xzhang03/DumberboxPCB/v1.3/PCB Dumberbox BOM.xlsx

Country of Origin may be different at time of shipment.
The HTSUS and ECCN information shown is for informational purposes only and is not a representation or warranty as to the accuracy or reliability of these classifications. All information is provided "as is" and is subject to change without notice. Any use made of the information provided is without recourse to Digi-Key and at the user's risk.
Index | Manufacturer Part Number | Manufacturer Name | Description | Availability | Stock Status | Attrition % | Requested Quantity 1 | Pack Quantity 1 | Pack Type 1 | Digi-Key Part Number 1 | Unit Price 1 | Extended Price 1 | Minimum Order Quantity 1 | Customer Reference | Requested Part Number | Lead Weeks | Datasheet | Reference Designator | US Import Tariff | Note | Part Status | RoHS Status | ECCN | HTSUS | Country of Origin | Environmental Information | Original Part numbers | Image
1 | 74HC14D-Q100,118 | Nexperia USA Inc. | IC INVERT SCHMITT 6CH 1-INP 14SO | 0 | Normally Stocking |  | 1 | 1 | Cut Tape (CT) | 1727-1029-1-ND | 0.53000 | $0.53 | 1 |  | 74HC14D-Q100,118 | 27 | https://assets.nexperia.com/documents/data-sheet/74HC_HCT14_Q100.pdf |  | May apply on shipments to the U.S. |  | Active | ROHS3 Compliant | EAR99 | 8542.39.0001 | China |  | 74HC14D-Q100,118 | //media.digikey.com/Renders/NXP%20Semi%20Renders/14-SOIC-SOT108-1.jpg
2 | 3677 | Adafruit Industries LLC | ITSY BITSY 32U4 5V 16MHZ EVAL BD | 154 | In Stock |  | 1 | 1 | Bulk | 1528-2501-ND | 9.95000 | $9.95 | 1 |  | 1528-2501-ND | 2 | https://cdn-learn.adafruit.com/downloads/pdf/introducting-itsy-bitsy-32u4.pdf |  | N/A |  | Active | ROHS3 Compliant | EAR99 | 8471.50.0150 | United States |  | 1528-2501-ND | //media.digikey.com/Photos/Adafruit%20Industries%20LLC/MFG_3677.jpg
3 | NCP1117ST50T3G | onsemi | IC REG LINEAR 5V 1A SOT223 | 242 | In Stock |  | 1 | 1 | Cut Tape (CT) | NCP1117ST50T3GOSCT-ND | 0.72000 | $0.72 | 1 |  | NCP1117ST50T3G | 58 | https://www.onsemi.com/pdf/datasheet/ncp1117-d.pdf |  | N/A |  | Active | ROHS3 Compliant | EAR99 | 8542.39.0001 | Malaysia | https://www.onsemi.com/PowerSolutions/MaterialComposition.do?export=pdf&opnId=NCP1117ST50T3G|https://www.onsemi.com/site/pdf/RoHS-statement.pdf|https://www.onsemi.com/site/pdf/REACH-compliance-statement.pdf | NCP1117ST50T3G | //media.digikey.com/Renders/Diodes%20Renders/SOT223-3L.jpg
4 | SJ-435107RS | CUI Devices | CONN JACK 4COND 3.5MM R/A | 15,403 | In Stock |  | 2 | 2 | Tray | CP-435107RS-ND | 1.78000 | $3.56 | 1 |  | CP-435107RS-ND | 24 | https://www.cuidevices.com/product/resource/sj-435107.pdf |  | N/A |  | Active | ROHS3 Compliant | EAR99 | 8536.69.4040 | China | https://www.cuidevices.com/product/resource/material-compliance/sj-435107-series | CP-435107RS-ND | //media.digikey.com/Photos/CUI%20Photos/MFG_SJ-435107.jpg
5 | 1-2834015-6 | TE Connectivity AMP Connectors | TERM BLK 6POS TOP ENT 2.54MM PCB | 1,683 | In Stock |  | 1 | 1 | Bulk | A123828-ND | 2.41000 | $2.41 | 1 |  | 1-2834015-6 | 39 | https://www.te.com/commerce/DocumentDelivery/DDEController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 |  | May apply on shipments to the U.S. |  | Active | RoHS Compliant | EAR99 | 8536.69.4040 | China |  | 1-2834015-6 | //media.digikey.com/photos/TE%20Connectivity/1-2834015-6.JPG
6 | PJ-102A | CUI Devices | CONN PWR JACK 2X5.5MM SOLDER | 92,528 | In Stock |  | 1 | 1 | Tray | CP-102A-ND | 0.77000 | $0.77 | 1 |  | PJ-102A | 24 | https://www.cuidevices.com/product/resource/pj-102a.pdf |  | N/A |  | Active | ROHS3 Compliant | EAR99 | 8536.69.4040 | China | https://www.cuidevices.com/product/resource/material-compliance/pj-102a | PJ-102A | //media.digikey.com/Photos/CUI%20Photos/PJ-102A.jpg
7 | XCMDK12D | SunLED | 5MM LC RED LED | 14,206 | In Stock |  | 1 | 1 | Bulk | 1497-XCMDK12D-ND | 0.35000 | $0.35 | 1 |  | 1497-XCMDK12D-ND | 8 | https://www.sunledusa.com/products/spec/XCMDK12D.pdf |  | May apply on shipments to the U.S. |  | Active | ROHS3 Compliant | EAR99 | 8541.41.0000 | China |  | 1497-XCMDK12D-ND | //media.digikey.com/Photos/SunLED/MFG_XCMDK12D.jpg
8 | AB11AH-HC | NKK Switches | SWITCH PUSH SPST-NO 0.4VA 28V | 2,152 | In Stock |  | 3 | 3 | Tray | 360-2604-ND | 6.46000 | $19.38 | 1 |  | AB11AH-HC | 22 | https://www.nkkswitches.com/pdf/Apushbuttons.pdf |  | N/A |  | Active | ROHS3 Compliant | EAR99 | 8536.50.9031 | Japan | https://www.nkkswitches.com/pdf/Switches-and-Pushbuttons-RoHS-Certificate-of-Compliance.pdf|https://www.nkkswitches.com/pdf/PFOS-and-PFOA-Free-Certificate.pdf|https://www.nkkswitches.com/pdf/Ozone-Depleting-Chemical-Free-Manufacturing-Certificate-.pdf | AB11AH-HC | //media.digikey.com/Photos/NKK%20Switches%20Photos/MFG_AB11AH-HC-RO.jpg
9 | 0731375003 | Molex | CONN BNC RCPT R/A 50 OHM PCB | 29,362 | In Stock |  | 4 | 4 | Tray | WM5514-ND | 2.65000 | $10.60 | 1 |  | 0731375003 | 12 | https://www.molex.com/pdm_docs/sd/731375003_sd.pdf |  | N/A |  | Active | ROHS3 Compliant | EAR99 | 8536.69.4010 | Taiwan |  | 0731375003 | //media.digikey.com/Photos/Molex/0731375003.jpg
10 | CR0805-FX-1000ELF | Bourns Inc. | RES SMD 100 OHM 1% 1/8W 0805 | 400,931 | In Stock |  | 4 | 4 | Cut Tape (CT) | CR0805-FX-1000ELFCT-ND | 0.10000 | $0.40 | 1 |  | CR0805-FX-1000ELFCT-ND | 15 | https://www.bourns.com/docs/product-datasheets/cr.pdf?sfvrsn=574d41f6_14 |  | N/A |  | Active | ROHS3 Compliant | EAR99 | 8533.21.0030 | Taiwan | https://www.bourns.com/docs/Product-MDS/cr0805_mds.pdf|https://www.bourns.com/docs/rohs-cofc/crx_coc.pdf?sfvrsn=db3a74f6_10|https://www.bourns.com/docs/rohs-content/bourns-reach-letter.pdf | CR0805-FX-1000ELFCT-ND | //media.digikey.com/Renders/Bourns%20Renders/CR0805-(2012-Metric).jpg
11 | CR0805-FX-3300ELF | Bourns Inc. | RES SMD 330 OHM 1% 1/8W 0805 | 49,443 | In Stock |  | 3 | 3 | Cut Tape (CT) | 118-CR0805-FX-3300ELFCT-ND | 0.10000 | $0.30 | 1 |  | CR0805-FX-3300ELF | 15 | https://www.bourns.com/docs/product-datasheets/cr.pdf?sfvrsn=574d41f6_14 |  | N/A |  | Active | ROHS3 Compliant | EAR99 | 8533.21.0030 | Taiwan | https://www.bourns.com/docs/Product-MDS/cr0805_mds.pdf|https://www.bourns.com/docs/rohs-cofc/crx_coc.pdf?sfvrsn=db3a74f6_10|https://www.bourns.com/docs/rohs-content/bourns-reach-letter.pdf | CR0805-FX-3300ELF | //media.digikey.com/Renders/Bourns%20Renders/CR0805-(2012-Metric).jpg
12 | CR0805-FX-1001ELF | Bourns Inc. | RES SMD 1K OHM 1% 1/8W 0805 | 1,558,028 | In Stock |  | 3 | 3 | Cut Tape (CT) | CR0805-FX-1001ELFCT-ND | 0.10000 | $0.30 | 1 |  | CR0805-FX-1001ELF | 15 | https://www.bourns.com/docs/product-datasheets/cr.pdf?sfvrsn=574d41f6_14 |  | N/A |  | Active | ROHS3 Compliant | EAR99 | 8533.21.0030 | Taiwan | https://www.bourns.com/docs/Product-MDS/cr0805_mds.pdf|https://www.bourns.com/docs/rohs-cofc/crx_coc.pdf?sfvrsn=db3a74f6_10|https://www.bourns.com/docs/rohs-content/bourns-reach-letter.pdf | CR0805-FX-1001ELF | //media.digikey.com/Renders/Bourns%20Renders/CR0805-(2012-Metric).jpg
13 | CR0805-FX-4701ELF | Bourns Inc. | RES SMD 4.7K OHM 1% 1/8W 0805 | 285,237 | In Stock |  | 2 | 2 | Cut Tape (CT) | CR0805-FX-4701ELFCT-ND | 0.10000 | $0.20 | 1 |  | CR0805-FX-4701ELF | 15 | https://www.bourns.com/docs/product-datasheets/cr.pdf?sfvrsn=574d41f6_14 |  | N/A |  | Active | ROHS3 Compliant | EAR99 | 8533.21.0030 | Taiwan | https://www.bourns.com/docs/Product-MDS/cr0805_mds.pdf|https://www.bourns.com/docs/rohs-cofc/crx_coc.pdf?sfvrsn=db3a74f6_10|https://www.bourns.com/docs/rohs-content/bourns-reach-letter.pdf | CR0805-FX-4701ELF | //media.digikey.com/Renders/Bourns%20Renders/CR0805-(2012-Metric).jpg
14 | CR0805-FX-1002ELF | Bourns Inc. | RES SMD 10K OHM 1% 1/8W 0805 | 587,325 | In Stock |  | 6 | 6 | Cut Tape (CT) | CR0805-FX-1002ELFCT-ND | 0.10000 | $0.60 | 1 |  | CR0805-FX-1002ELF | 15 | https://www.bourns.com/docs/product-datasheets/cr.pdf?sfvrsn=574d41f6_14 |  | N/A |  | Active | ROHS3 Compliant | EAR99 | 8533.21.0030 | Taiwan | https://www.bourns.com/docs/Product-MDS/cr0805_mds.pdf|https://www.bourns.com/docs/rohs-cofc/crx_coc.pdf?sfvrsn=db3a74f6_10|https://www.bourns.com/docs/rohs-content/bourns-reach-letter.pdf | CR0805-FX-1002ELF | //media.digikey.com/Renders/Bourns%20Renders/CR0805-(2012-Metric).jpg
15 | 3296W-1-102LF | Bourns Inc. | TRIMMER 1K OHM 0.5W PC PIN TOP | 20,122 | In Stock |  | 1 | 1 | Tube | 3296W-102LF-ND | 2.43000 | $2.43 | 1 |  | 3296W-102LF-ND | 18 | https://www.bourns.com/docs/product-datasheets/3296.pdf |  | N/A |  | Active | ROHS3 Compliant | EAR99 | 8533.40.8050 | Costa Rica | https://www.bourns.com/docs/rohs-cofc/cofc_trim1.pdf?sfvrsn=ec972807_4 | 3296W-102LF-ND | //media.digikey.com/photos/Bourns%20Photos/3296W%20SERIES.jpg
16 | LS R976-NR-1 | ams-OSRAM USA Inc. | LED RED DIFFUSED 0805 SMD | 134,296 | In Stock |  | 3 | 3 | Cut Tape (CT) | 475-1278-1-ND | 0.30000 | $0.90 | 1 |  | LS R976-NR-1 | 14 | https://dammedia.osram.info/media/resource/hires/osram-dam-5178068/LS%20R976_EN.pdf |  | N/A |  | Active | ROHS3 Compliant | EAR99 | 8541.41.0000 | Taiwan |  | LS R976-NR-1 | //media.digikey.com/Renders/Osram%20Opto%20Renders/Chippled%200805.jpg
17 | CL21B105KAFNNNE | Samsung Electro-Mechanics | CAP CER 1UF 25V X7R 0805 | 1,817,936 | In Stock |  | 3 | 3 | Cut Tape (CT) | 1276-1066-1-ND | 0.10000 | $0.30 | 1 |  | CL21B105KAFNNNE | 22 | //media.digikey.com/pdf/Data%20Sheets/Samsung%20PDFs/CL21B105KAFNNNE_Spec.pdf |  | N/A |  | Active | ROHS3 Compliant | EAR99 | 8532.24.0020 | China | https://www.samsungsem.com/global/support/certificate/product-stewardship.do|https://www.samsungsem.com/files/fileDown.do?key=ed1dfdfa-645e-4252-b707-17f9b1502dd1 | CL21B105KAFNNNE | //media.digikey.com/Renders/Samsung%20Electro-Mechanics%20America/Ceramic-Capacitor-CL-Series.jpg
18 | CL21A106KPFNNNE | Samsung Electro-Mechanics | CAP CER 10UF 10V X5R 0805 | 2,792,077 | In Stock |  | 2 | 2 | Cut Tape (CT) | 1276-1052-1-ND | 0.11000 | $0.22 | 1 |  | CL21A106KPFNNNE | 22 | https://www.samsungsem.com/kr/support/product-search/mlcc/CL21A106KPFNNNE.jsp |  | N/A |  | Active | ROHS3 Compliant | EAR99 | 8532.24.0020 | China | https://www.samsungsem.com/global/support/certificate/product-stewardship.do|https://www.samsungsem.com/files/fileDown.do?key=ed1dfdfa-645e-4252-b707-17f9b1502dd1 | CL21A106KPFNNNE | //media.digikey.com/Renders/Samsung%20Electro-Mechanics%20America/Ceramic-Capacitor-CL-Series.jpg
19 | A12AP | NKK Switches | SWITCH TOGGLE SPDT 0.4VA 28V | 6,450 | In Stock |  | 1 | 1 | Tray | 360-3252-ND | 4.97000 | $4.97 | 1 |  | A12AP | 22 | https://www.nkkswitches.com/pdf/Atoggles.pdf |  | N/A |  | Active | ROHS3 Compliant | EAR99 | 8536.50.9065 | Japan | https://www.nkkswitches.com/pdf/Switches-and-Pushbuttons-RoHS-Certificate-of-Compliance.pdf|https://www.nkkswitches.com/pdf/PFOS-and-PFOA-Free-Certificate.pdf|https://www.nkkswitches.com/pdf/Ozone-Depleting-Chemical-Free-Manufacturing-Certificate-.pdf | A12AP | //media.digikey.com/Photos/NKK%20Switches%20Photos/A12AP.jpg
20 | TIP122G | onsemi | TRANS NPN DARL 100V 5A TO220 | 1,947 | In Stock |  | 3 | 3 | Tube | TIP122GOS-ND | 0.90000 | $2.70 | 1 |  | TIP122GOS-ND | 77 | https://www.onsemi.com/pdf/datasheet/tip120-d.pdf |  | May apply on shipments to the U.S. |  | Active | ROHS3 Compliant | EAR99 | 8541.29.0095 | China | https://www.onsemi.com/PowerSolutions/MaterialComposition.do?export=pdf&opnId=TIP122G|https://www.onsemi.com/site/pdf/RoHS-statement.pdf|https://www.onsemi.com/site/pdf/REACH-compliance-statement.pdf | TIP122GOS-ND | //media.digikey.com/Renders/On%20Semi%20Renders/TO-220-3.jpg
21 | 1N4001-G | Comchip Technology | DIODE GEN PURP 50V 1A DO41 | 97,419 | In Stock |  | 3 | 3 | Cut Tape (CT) | 641-1310-1-ND | 0.21000 | $0.63 | 1 |  | 1N4001-G | 10 | https://www.comchiptech.com/admin/files/product/1N4001-G%20Thru.%201N4007-G%20RevB.pdf |  | N/A |  | Active | ROHS3 Compliant | EAR99 | 8541.10.0080 | Taiwan | https://www.comchiptech.com/admin/files/tech/213_20201006093628.pdf | 1N4001-G | //media.digikey.com/Photos/Comchip%20Tech%20Photos/1N5819-G.JPG
