xzhang03/DumberboxPCB/(list of files, drawings)

Other design files:
v1.0/EasyEDA_PCB_DumberboxPCB_2022-06-06.json
v1.1/EasyEDA_PCB_PCB_DumberboxPCB_2022-06-22.json
v1.1/EasyEDA_SCH_DumberboxPCB_2022-06-22.json
v1.2/EasyEDA_PCB_DumberboxPCB_2022-09-26.json
v1.2/EasyEDA_PCB_PCB_DumberboxPCB_2022-07-02.json
v1.2/EasyEDA_SCH_DumberboxPCB_2022-07-02.json
v1.3/PCB_PCB_DumberboxPCB_2024-10-31.json
v1.3/SCH_DumberboxPCB_2024-10-31.json
