xzhang03/DumberboxPCB/(commit log)

2022-06-07 initial upload
    [EasyEDA_PCB_DumberboxPCB_2022-06-06.json]
2022-06-08 arduino code upload
2022-09-27 updated versions
    [EasyEDA_PCB_DumberboxPCB_2022-09-16.json, EasyEDA_PCB_DumberboxPCB_2022-09-26.json, EasyEDA_PCB_DumberboxPCB_2022-09-27.json, EasyEDA_SCH_DumberboxPCB_2022-09-27.json, PCB Dumberbox BOM.xlsx]
2022-09-27 silkscreen updates
    [EasyEDA_PCB_DumberboxPCB_2022-09-27.json]
2022-09-27 added jumper option for pot
    [EasyEDA_PCB_DumberboxPCB_2022-09-27.json]
2022-12-05 foot print for box design
2023-08-07 moved old stuff
    [EasyEDA_PCB_DumberboxPCB_2022-06-06.json, EasyEDA_PCB_DumberboxPCB_2022-09-26.json, EasyEDA_PCB_PCB_DumberboxPCB_2022-06-22.json, EasyEDA_SCH_DumberboxPCB_2022-06-22.json, EasyEDA_SCH_DumberboxPCB_2022-07-02.json]
